akuker/piccolo/TS-1187A-B-A-B/TS-1187A-B-A-B.step

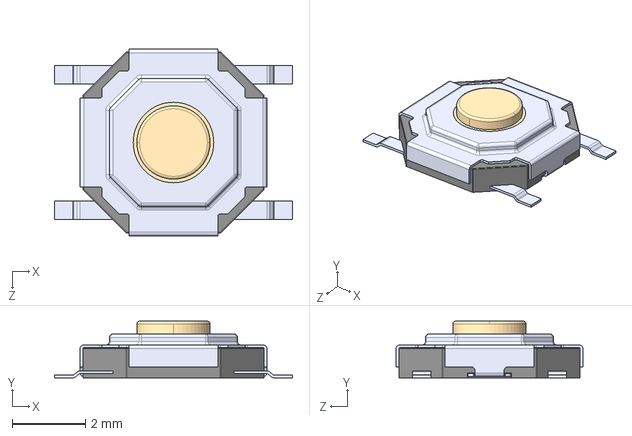
[picture p1: CAD file, 2023-03-19]
TS-1187A-B-A-B/TS-1187A-B-A-B.step
6.50 x 1.55 x 5.10 mm
