akuker/piccolo/piccolo.kicad_pcb

## KiCad design piccolo.kicad_pcb (2023-03-19)

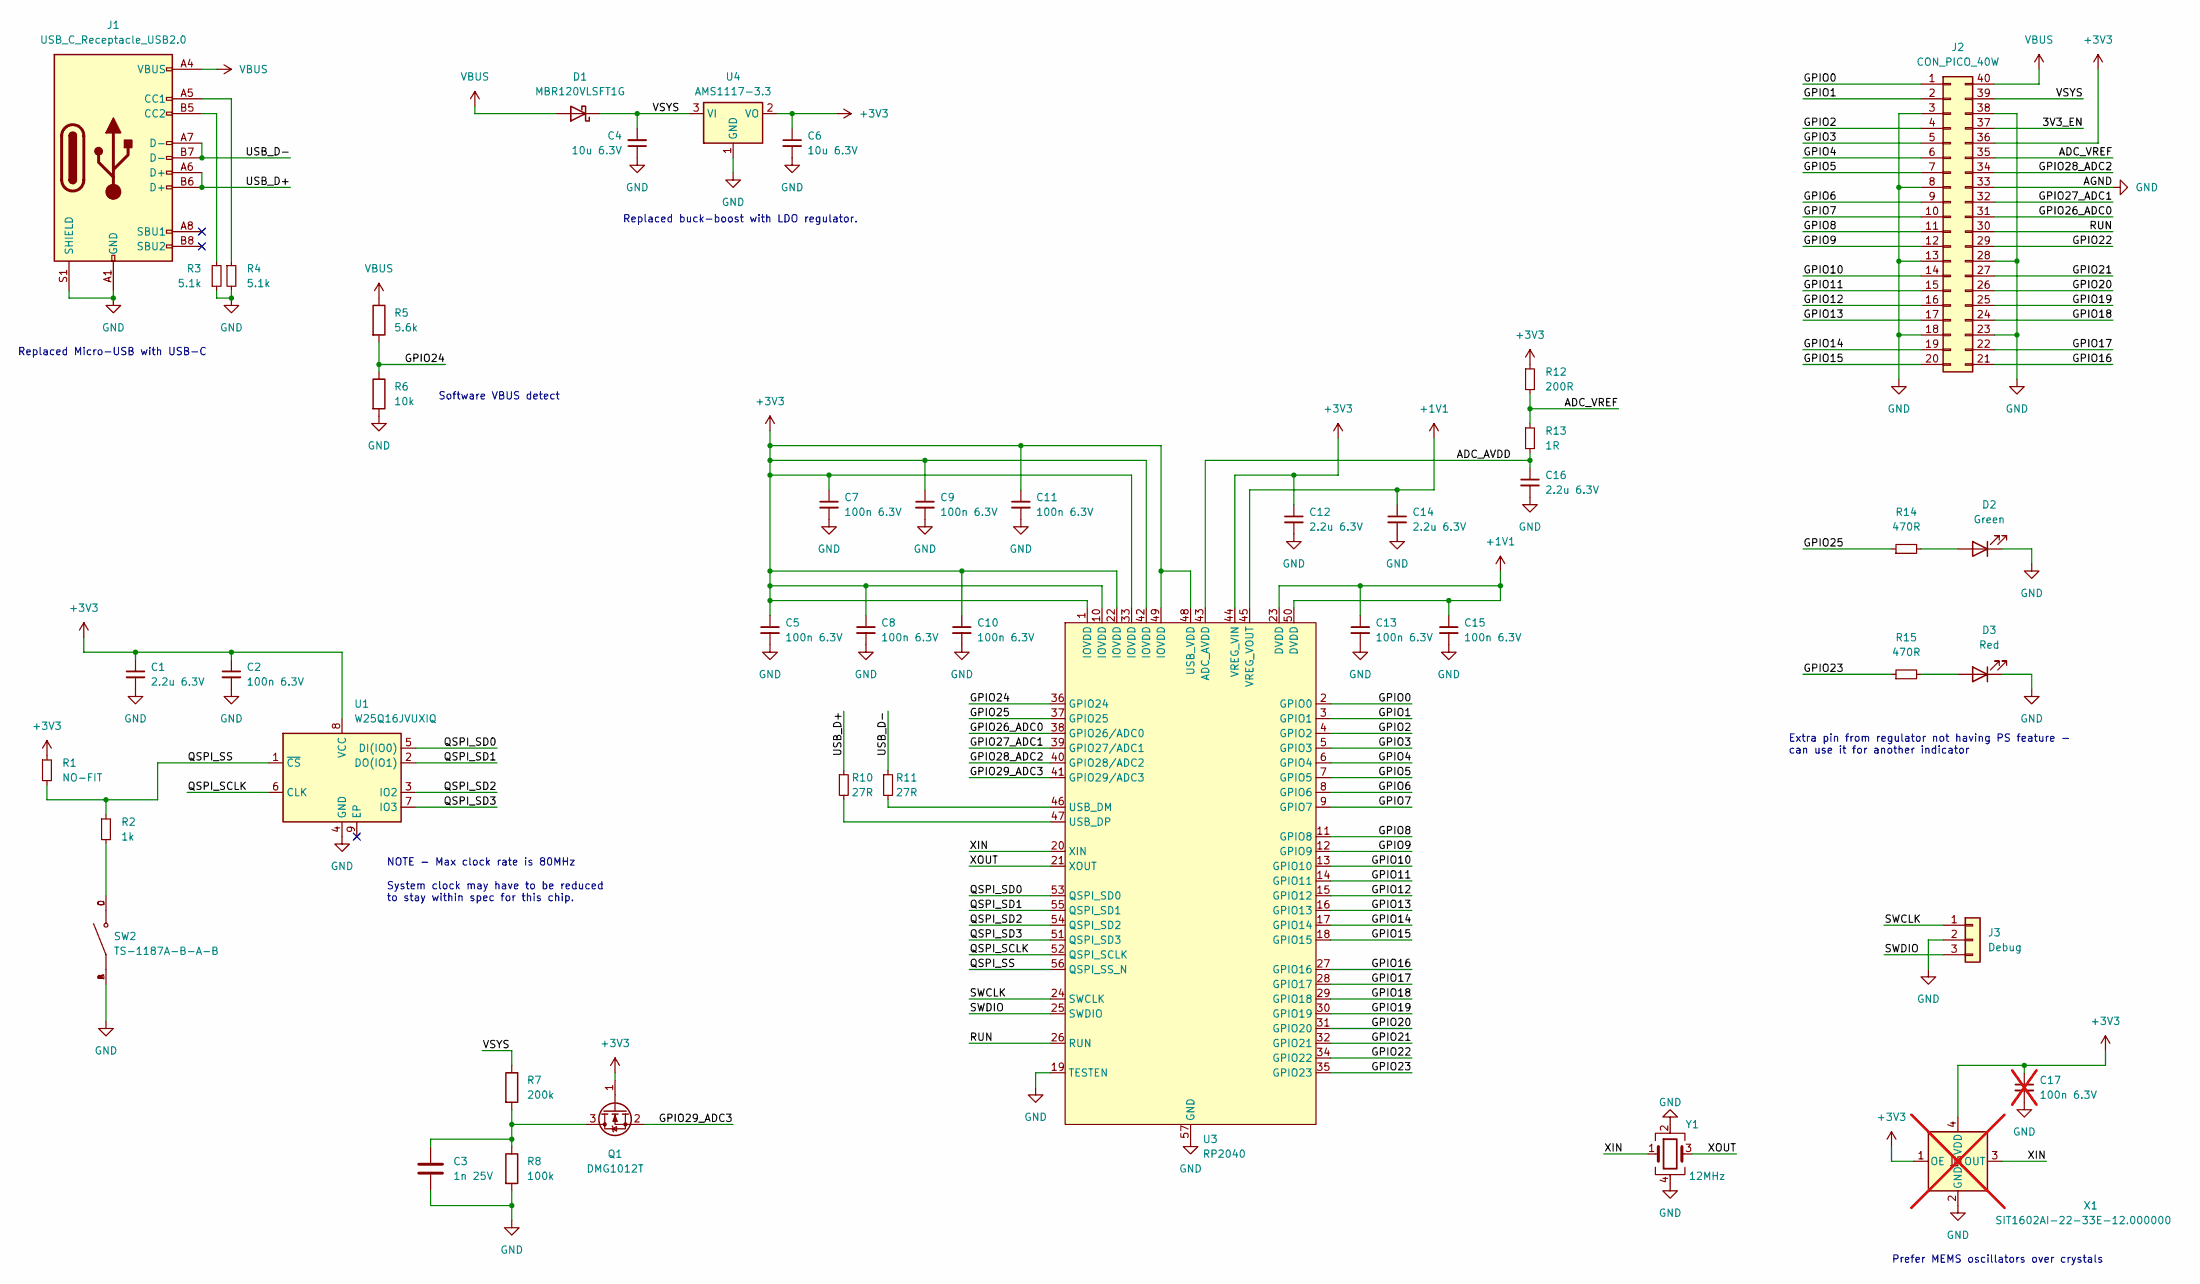
[picture p2: schematic piccolo.kicad_sch]

Parts:
C1, C12, C14, C16: 2.2u 6.3V; C_0402_1005Metric; Part Number CL05A225KQ5NNNC; LCSC C12530
C2, C5, C7, C8, C9, C10, C11, C13, C15: 100n 6.3V; C_0402_1005Metric; Part Number CL03A104KQ3NNNC; LCSC C1525
C3: 1n 25V; C_0402_1005Metric; Part Number 04023C102KAT2A; LCSC C1523
C4, C6: 10u 6.3V; C_0805_2012Metric; Part Number CL21A106MQFNNNE; LCSC C440198
C17: 100n 6.3V; C_0402_1005Metric; Part Number CL03A104KQ3NNNC; LCSC C1525; not fitted
D1: MBR120VLSFT1G; D_SOD-123F; Part Number MBR120VLSFT1G; LCSC C123070
D2: Green; LED_0603_1608Metric; Part Number LTST-C191KGKT; LCSC C72043
D3: Red; LED_0603_1608Metric; Part Number LTST-C191KRKT; LCSC C72043
J1: USB_C_Receptacle_USB2.0; USB_C_Receptacle_HRO_TYPE-C-31-M-12; Part Number TYPE-C-31-M-12; LCSC C165948
J2: CON_PICO_40W; RaspberryPi_Pico_OutlineAndPads
J3: Debug; PinHeader_1x03_P2.54mm_Vertical
Q1: DMG1012T; SOT-523; Part Number DMG1012T; LCSC C2830301
R1: NO-FIT; R_0402_1005Metric
R2: 1k; R_0402_1005Metric; Part Number RC0402FR-071KL; LCSC C11702
R3, R4: 5.1k; R_0402_1005Metric; Part Number RC0402FR-075K1L; LCSC C25905
R5: 5.6k; R_0402_1005Metric; Part Number RC0402FR-075K6L; LCSC C25908
R6: 10k; R_0402_1005Metric; Part Number RC0402FR-0710KL; LCSC C25744
R7: 200k; R_0402_1005Metric; Part Number RC0402FR-07200KL; LCSC C25764
R8: 100k; R_0402_1005Metric; Part Number RC0402FR-07100KL; LCSC C25741
R10, R11: 27R; R_0201_0603Metric; Part Number RC0201FR-0727RL; LCSC C25100
R12: 200R; R_0603_1608Metric; Part Number RMCF0603FT200R; LCSC C25087
R13: 1R; R_0402_1005Metric; Part Number RC0402FR-071RL; LCSC C25086
R14, R15: 470R; R_0402_1005Metric; Part Number RC0402FR-07470RL; LCSC C25117
SW2: TS-1187A-B-A-B; SW_TS-1187A-B-A-B; PARTREV A0
U1: W25Q16JVUXIQ; USON-8-1EP_3x2mm_P0.5mm_EP0.2x1.6mm; Part Number W25Q16JVUXIQ; LCSC C152595
U3: RP2040; QFN-56-1EP_7x7mm_P0.4mm_EP3.2x3.2mm; Part Number RP2040; LCSC C2040
U4: AMS1117-3.3; SOT-223-3_TabPin2; LCSC C6186
X1: SIT1602AI-22-33E-12.000000; Crystal_SMD_SeikoEpson_TSX3225-4Pin_3.2x2.5mm; Part Number SIT1602AI-22-33E-12.000000; LCSC C29752; not fitted
Y1: 12MHz; Crystal_SMD_3225-4Pin_3.2x2.5mm

Connections:
+1V1: C13.1, C14.1, C15.1, U3.23 (DVDD), U3.45 (VREG_VOUT), U3.50 (DVDD)
+3V3: C1.1, C2.1, C5.1, C6.1, C7.1, C8.1, C9.1, C10.1, C11.1, C12.1, C17.1, J2.36, Q1.1 (G), R1.1, R12.1, U1.8 (VCC), U3.1 (IOVDD), U3.10 (IOVDD), U3.22 (IOVDD), U3.33 (IOVDD), U3.42 (IOVDD), U3.44 (VREG_VIN), U3.48 (USB_VDD), U3.49 (IOVDD), U4.2 (VO), X1.1 (OE), X1.4 (VDD)
/3V3_EN: J2.37
/ADC_AVDD: C16.1, R13.2, U3.43 (ADC_AVDD)
/ADC_VREF: J2.35, R12.2, R13.1
/GPIO0: J2.1, U3.2 (GPIO0)
/GPIO1: J2.2, U3.3 (GPIO1)
/GPIO2: J2.4, U3.4 (GPIO2)
/GPIO3: J2.5, U3.5 (GPIO3)
/GPIO4: J2.6, U3.6 (GPIO4)
/GPIO5: J2.7, U3.7 (GPIO5)
/GPIO6: J2.9, U3.8 (GPIO6)
/GPIO7: J2.10, U3.9 (GPIO7)
/GPIO8: J2.11, U3.11 (GPIO8)
/GPIO9: J2.12, U3.12 (GPIO9)
/GPIO10: J2.14, U3.13 (GPIO10)
/GPIO11: J2.15, U3.14 (GPIO11)
/GPIO12: J2.16, U3.15 (GPIO12)
/GPIO13: J2.17, U3.16 (GPIO13)
/GPIO14: J2.19, U3.17 (GPIO14)
/GPIO15: J2.20, U3.18 (GPIO15)
/GPIO16: J2.21, U3.27 (GPIO16)
/GPIO17: J2.22, U3.28 (GPIO17)
/GPIO18: J2.24, U3.29 (GPIO18)
/GPIO19: J2.25, U3.30 (GPIO19)
/GPIO20: J2.26, U3.31 (GPIO20)
/GPIO21: J2.27, U3.32 (GPIO21)
/GPIO22: J2.29, U3.34 (GPIO22)
/GPIO23: R15.1, U3.35 (GPIO23)
/GPIO24: R5.2, R6.1, U3.36 (GPIO24)
/GPIO25: R14.1, U3.37 (GPIO25)
/GPIO26_ADC0: J2.31, U3.38 (GPIO26/ADC0)
/GPIO27_ADC1: J2.32, U3.39 (GPIO27/ADC1)
/GPIO28_ADC2: J2.34, U3.40 (GPIO28/ADC2)
/GPIO29_ADC3: Q1.2 (S), U3.41 (GPIO29/ADC3)
/QSPI_SCLK: U1.6 (CLK), U3.52 (QSPI_SCLK)
/QSPI_SD0: U1.5 (DI(IO0)), U3.53 (QSPI_SD0)
/QSPI_SD1: U1.2 (DO(IO1)), U3.55 (QSPI_SD1)
/QSPI_SD2: U1.3 (IO2), U3.54 (QSPI_SD2)
/QSPI_SD3: U1.7 (IO3), U3.51 (QSPI_SD3)
/QSPI_SS: R1.2, R2.1, U1.1 (~CS), U3.56 (QSPI_SS_N)
/RUN: J2.30, U3.26 (RUN)
/SWCLK: J3.1, U3.24 (SWCLK)
/SWDIO: J3.3, U3.25 (SWDIO)
/USB_D+: J1.A6 (D+), J1.B6 (D+), R10.1
/USB_D-: J1.A7 (D-), J1.B7 (D-), R11.1
/VSYS: C4.2, D1.1 (K), J2.39, R7.1, U4.3 (VI)
/XIN: U3.20 (XIN), X1.3 (OUT), Y1.1
/XOUT: U3.21 (XOUT), Y1.3
GND: C1.2, C2.2, C3.2, C4.1, C5.2, C6.2, C7.2, C8.2, C9.2, C10.2, C11.2, C12.2, C13.2, C14.2, C15.2, C16.2, C17.2, D2.1 (K), D3.1 (K), J1.A1 (GND), J1.A12 (GND), J1.B1 (GND), J1.B12 (GND), J1.S1 (SHIELD), J2.3, J2.8, J2.13, J2.18, J2.23, J2.28, J2.33, J2.38, J3.2, R3.1, R4.2, R6.2, R8.2, SW2.A, SW2.B, U1.4 (GND), U3.19 (TESTEN), U3.57 (GND), U4.1 (GND), X1.2 (GND), Y1.2, Y1.4
unnamed: D2.2 (A), R14.2
unnamed: D3.2 (A), R15.2
unnamed: J1.A5 (CC1), R4.1
unnamed: J1.B5 (CC2), R3.2
unnamed: C3.1, Q1.3 (D), R7.2, R8.1
unnamed: R2.2, SW2.C, SW2.D
unnamed: R11.2, U3.46 (USB_DM)
unnamed: R10.2, U3.47 (USB_DP)
VBUS: D1.2 (A), J1.A4 (VBUS), J1.A9 (VBUS), J1.B4 (VBUS), J1.B9 (VBUS), J2.40, R5.1

Notes on the sheet:
Replaced buck-boost with LDO regulator.
Prefer MEMS oscillators over crystals
Replaced Micro-USB with USB-C
Extra pin from regulator not having PS feature - can use it for another indicator
Software VBUS detect
NOTE - Max clock rate is 80MHz System clock may have to be reduced to stay within spec for this chip.

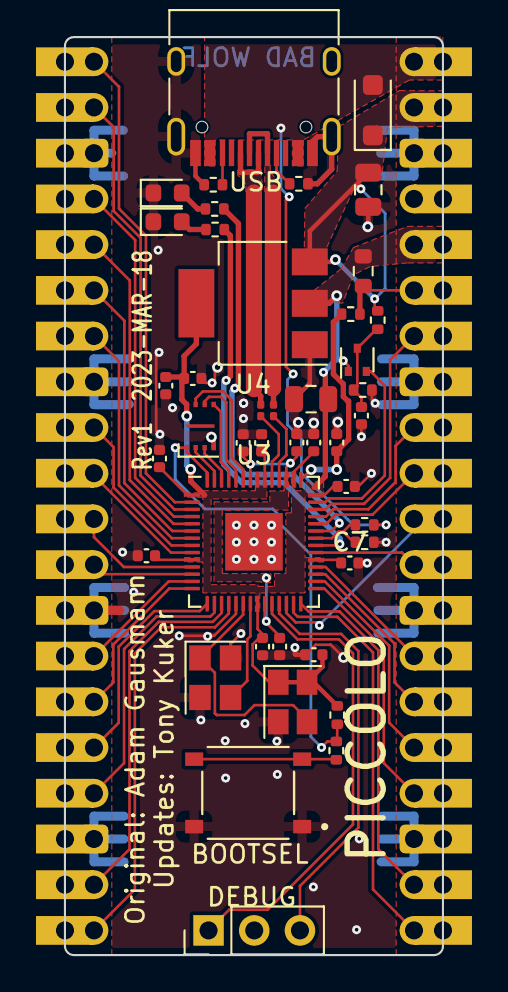
[picture p3: board piccolo.kicad_pcb from above]

Board: 2 copper layers, 21.0 x 51.0 mm, 44 parts (0 on the bottom side), 58 nets.
