akuker/piccolo/(threads)

Thread 1 (2023-03-29):

Standard Pico MicroPython doesn't work with akuker/piccolo

akuker, 2023-03-29:
Version 1 of akuker/piccolo is not fully compatible with the Raspberry Pi Pico. A non-standard flash device was used, which requires a modification to the second stage bootloader. Someone with a similar issue is talked about here:
https://forums.raspberrypi.com/viewtopic.php?t=334143

With the current design, the BOOTSEL function will work to load u2f files. However, when the board tries to run the u2f file, the board hangs.

All of the software build for this board needs to have the PICO_BOOT_STAGE2_CHOOSE_GENERIC_03H option enabled in the code.

For MicroPython, you typically don't re-build it.

The rebuild instructions for rp2040 MicroPython are available here: https://github.com/micropython/micropython/tree/master/ports/rp2

After you checkout micropython, you need to apply the following two patches.

Patch 1 should be applied to the root checkout of micropython
[0001_piccolo_board_configuration.patch](https://github.com/akuker/piccolo/files/11095754/0001_piccolo_board_configuration.patch)

Patch 2 should be applied to the pico-sdk (./micropython/lib/pico-sdk/). You may need to do `make submodules` before the pico-sdk is checked out.
[0002_piccolo_rp2040_sdk.patch](https://github.com/akuker/piccolo/files/11095757/0002_piccolo_rp2040_sdk.patch)

The pre-built MicroPython with PICO_BOOT_STAGE2_CHOOSE_GENERIC_03H enabled is also attached. Its build from revision [38e7b84](https://github.com/micropython/micropython/commit/38e7b842c6bc8122753cbf0845eb141f28fbcb72)

[MicroPython_Firmware.zip](https://github.com/akuker/piccolo/files/11095782/MicroPython_Firmware.zip)

akuker, 2023-03-29:
Forked code available here: https://github.com/akuker/micropython-piccolo

But, you still need to apply the pico-sdk patch.

Thread 3 (2023-03-29):

Hacky Castellated holes didn't turn out well

akuker, 2023-03-29:
Having "real" castellated holes on the board adds to the production cost.

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

An attempt was made with revision 1 to create pseudo-castellated holes by having a regular hole, then using the edge cuts to slice it in half. BUT, the castellated holes option was NOT selected for manufacturing. This was a worthwhile attempt, but in practice, the results from JLCPCB were not clean.

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

In the next revision, the design should be updated to use real castellated holes (and pay the extra manufacturing costs) or remove them.

akuker, 2023-03-29:
This document sums it up pretty well: https://jlcpcb.com/quote/pcbOrderFaq/Castellated%20holes

Regarding the castellated holes option:

> 1. If "Yes" is checked, the castellated holes will be made with a special process and extra cost will be charged.
> 2. If "No" is checked, the castellated holes will still be made but with the ordinary process, so the quality is not promised (e.g. defects may highly occur: unplated holes, incomplete plating, hole with copper residues etc.).
